redlightASl/OurEDA-B2S/Doc/动力舱控制板接插件v2.jpg

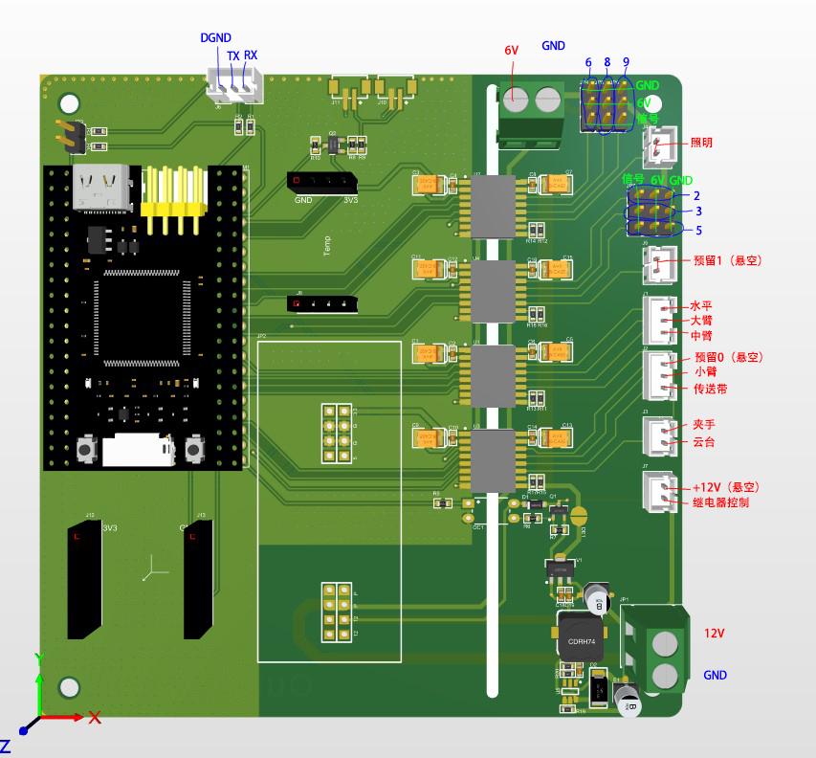
Doc/动力舱控制板接插件v2.jpg
