redlightASl/OurEDA-B2S/Doc/GW1NSR架构图.jpg

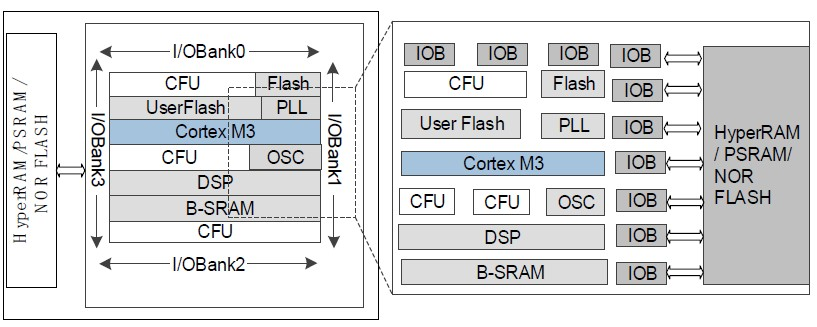
Doc/GW1NSR架构图.jpg
