redlightASl/OurEDA-B2S/README.md

# OurEDA-B2S

一个水下机器人（ROV/AUV）的下位仓控制系统，由[OurEDA-B1S](https://github.com/zyn810039594/OurEDA-B1S)更新得来

请使用Arduino、CubeMX、CubeIDE访问相关代码，使用AD打开硬件原理图和PCB Layout设计

系统架构图如`Doc/OurEDA-B2S`所示

## 子模块Submodule

该项目衍生出的仓库包括

[小体积水深解算板](https://github.com/redlightASl/ROV_SensorBoard)

[AD常用封装库整理](https://github.com/redlightASl/Lib-ADP)
