redlightASl/OurEDA-B2S/Software/WaterDepth/README.md

# 水深传感器解算板

**测试中发现I2C传输出现问题**

暂未修复

考虑到后续需要添加其他I2C设备，故制作基于GD32/STM32的新款水深解算板

## 已废弃
