redlightASl/OurEDA-B2S/Hardware/Board/CtrlCarbinBoard/CtrlCarbinBoard.PcbDoc.htm

Reporting Options

# File in Previous Format

Date | : | 2022/4/24
Time | : | 15:39:36
Filename | : | F:\Git_repository\OurEDA\OurEDA-B2S\Hardware\Board\CtrlCarbinBoard\CtrlCarbinBoard.PcbDoc

Version | Warning

This file was generated by an earlier version of the software
