redlightASl/OurEDA-B2S/Hardware/Board/WaterDepthAnalysisBoard/WaterDepth.PcbDoc.htm

Reporting Options

# File in Previous Format

Date | : | 2022/3/30
Time | : | 19:57:03
Filename | : | F:\Git_repository\OurEDA\OurEDA-B2S\Hardware\Board\WaterDepthAnalysisBoard\WaterDepth.PcbDoc

Version | Warning

This file was generated by an earlier version of the software
