redlightASl/OurEDA-B2S/DataFormat/README.md

# 自定义协议帧

使用串口实现协议传输

下传指令格式：CtrlFormat.xlsx

上传指令格式：DataFormat.xlsx

### ROV-Debugger格式

`05DC:05DC:05DC:05DC:05DC:05DC:05DC:05DC:05DC:05DC:05DC:05DC:05DC`
