redlightASl/OurEDA-B2S/OpenWrt/README.md

# 控制仓的OpenWrt移植

控制仓中使用一个OpenWrt设备作为网络主控

配合stm32h750读取传感器数据和进行辅助计算

（如果后续有可能的话会使用Zynq将所有设备取代）

## 初步设计

使用**MT7688A**模块替代原来的MT7921模块，新模块特性如下

* 降级为百兆交换机/路由器
* 更高的CPU频率
* 支持WIFI
* 更好的openwrt官方支持（新版本，支持大多数需要的软件包）
* 更小的体积占用

测试中出现以下bug：

* ~~硬件复位卡死~~
* ~~软件复位reboot卡死~~
* **不提供固件、uboot，如果损坏只能维修或重新购买设备**
* usb引出存在问题（可能由于杜邦线问题导致USB连接失灵时不灵）
* 多摄像头传输时帧数明显低于7621（影响较小）
