redlightASl/OurEDA-B2S/Hardware/Board/README.md

# 硬件设计

CtrlCarbinBoard 控制仓PCB

PowCarbinBoard 电源仓PCB

WaterDepthAnalysisBoard 水深解算板PCB
