redlightASl/OurEDA-B2S/Hardware/Board/WaterDepthAnalysisBoard/README.md

# 水深传感器解算板

使用stm8重写深度解算板的程序，并采用邮票孔封装（因为没钱拼板，实际使用2.54排针，直接切割焊盘分成两块板）制作成电路模块
