redlightASl/OurEDA-B2S/Doc/M3硬核架构图.jpg

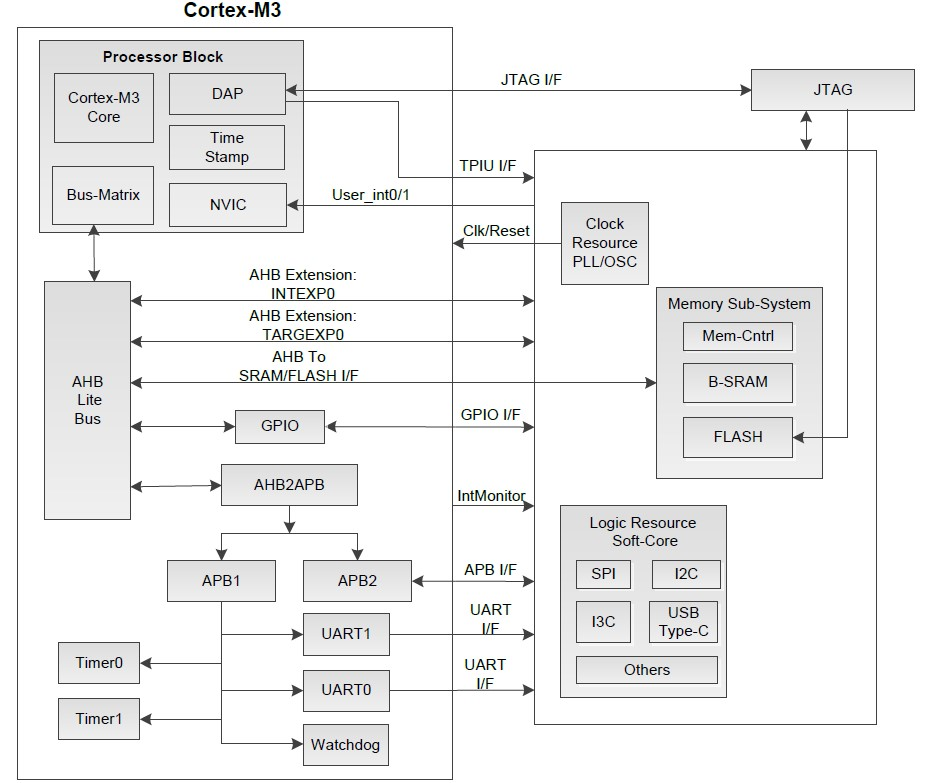
Doc/M3硬核架构图.jpg
