redlightASl/OurEDA-B2S/Hardware/Board/WaterDepthAnalysisBoard/Project Outputs for WaterDepth/WaterDepth.xls

Comment | Description | Designator | Footprint | LibRef | Quantity
104 | 无极性贴片电容 | C1, C2, C3, C4, C5, C6, C7, C8, C9, C10 | C 0603_L | C | 10
HDR-1X4 | 4P接插件 | JP1, JP2 | MX 1.25-LS-4P | Header 4 | 2
Header 8X2 | 8*2P接插件 | JP3 | HDR2.54-LI-2x8P | Header 8X2 | 1
红色 | 贴片LED | LED1, LED2, LED3, LED4 | LED 0603W | LED-SMD | 4
NPN | NPN三极管 | Q1, Q2 | SOT-23 | NPN | 2
33K | 贴片电阻 | R1, R5 | R 0603_L | R | 2
3.3K | 贴片电阻 | R2, R3, R4, R6, R7, R8 | R 0603_L | R | 6
4.7K | 贴片电阻 | R9, R10, R11, R12 | R 0603_L | R | 4
TEST | 测试点 | TP1, TP2, TP3, TP4, TP5, TP6, TP7, TP8 | TEST 1 | TEST | 8
STM8L101F3P6 | MCU | U1, U2 | TSSOP-20 | STM8L101F3P6 | 2
AMS1117-3V3 | 三端稳压芯片 | V1, V2 | SOT89_N | AMS1117 | 2
