redlightASl/OurEDA-B2S/(list of files, cad)

Other CAD files:
Software/WaterDepth/stm8_uart.stp
Software/WaterDepth/stm8_uart_Programmer/stm8_uart_STVP.stp
