redlightASl/OurEDA-B2S/Hardware/Board/PowCarbinBoard/PowCarbinBoard.pdf

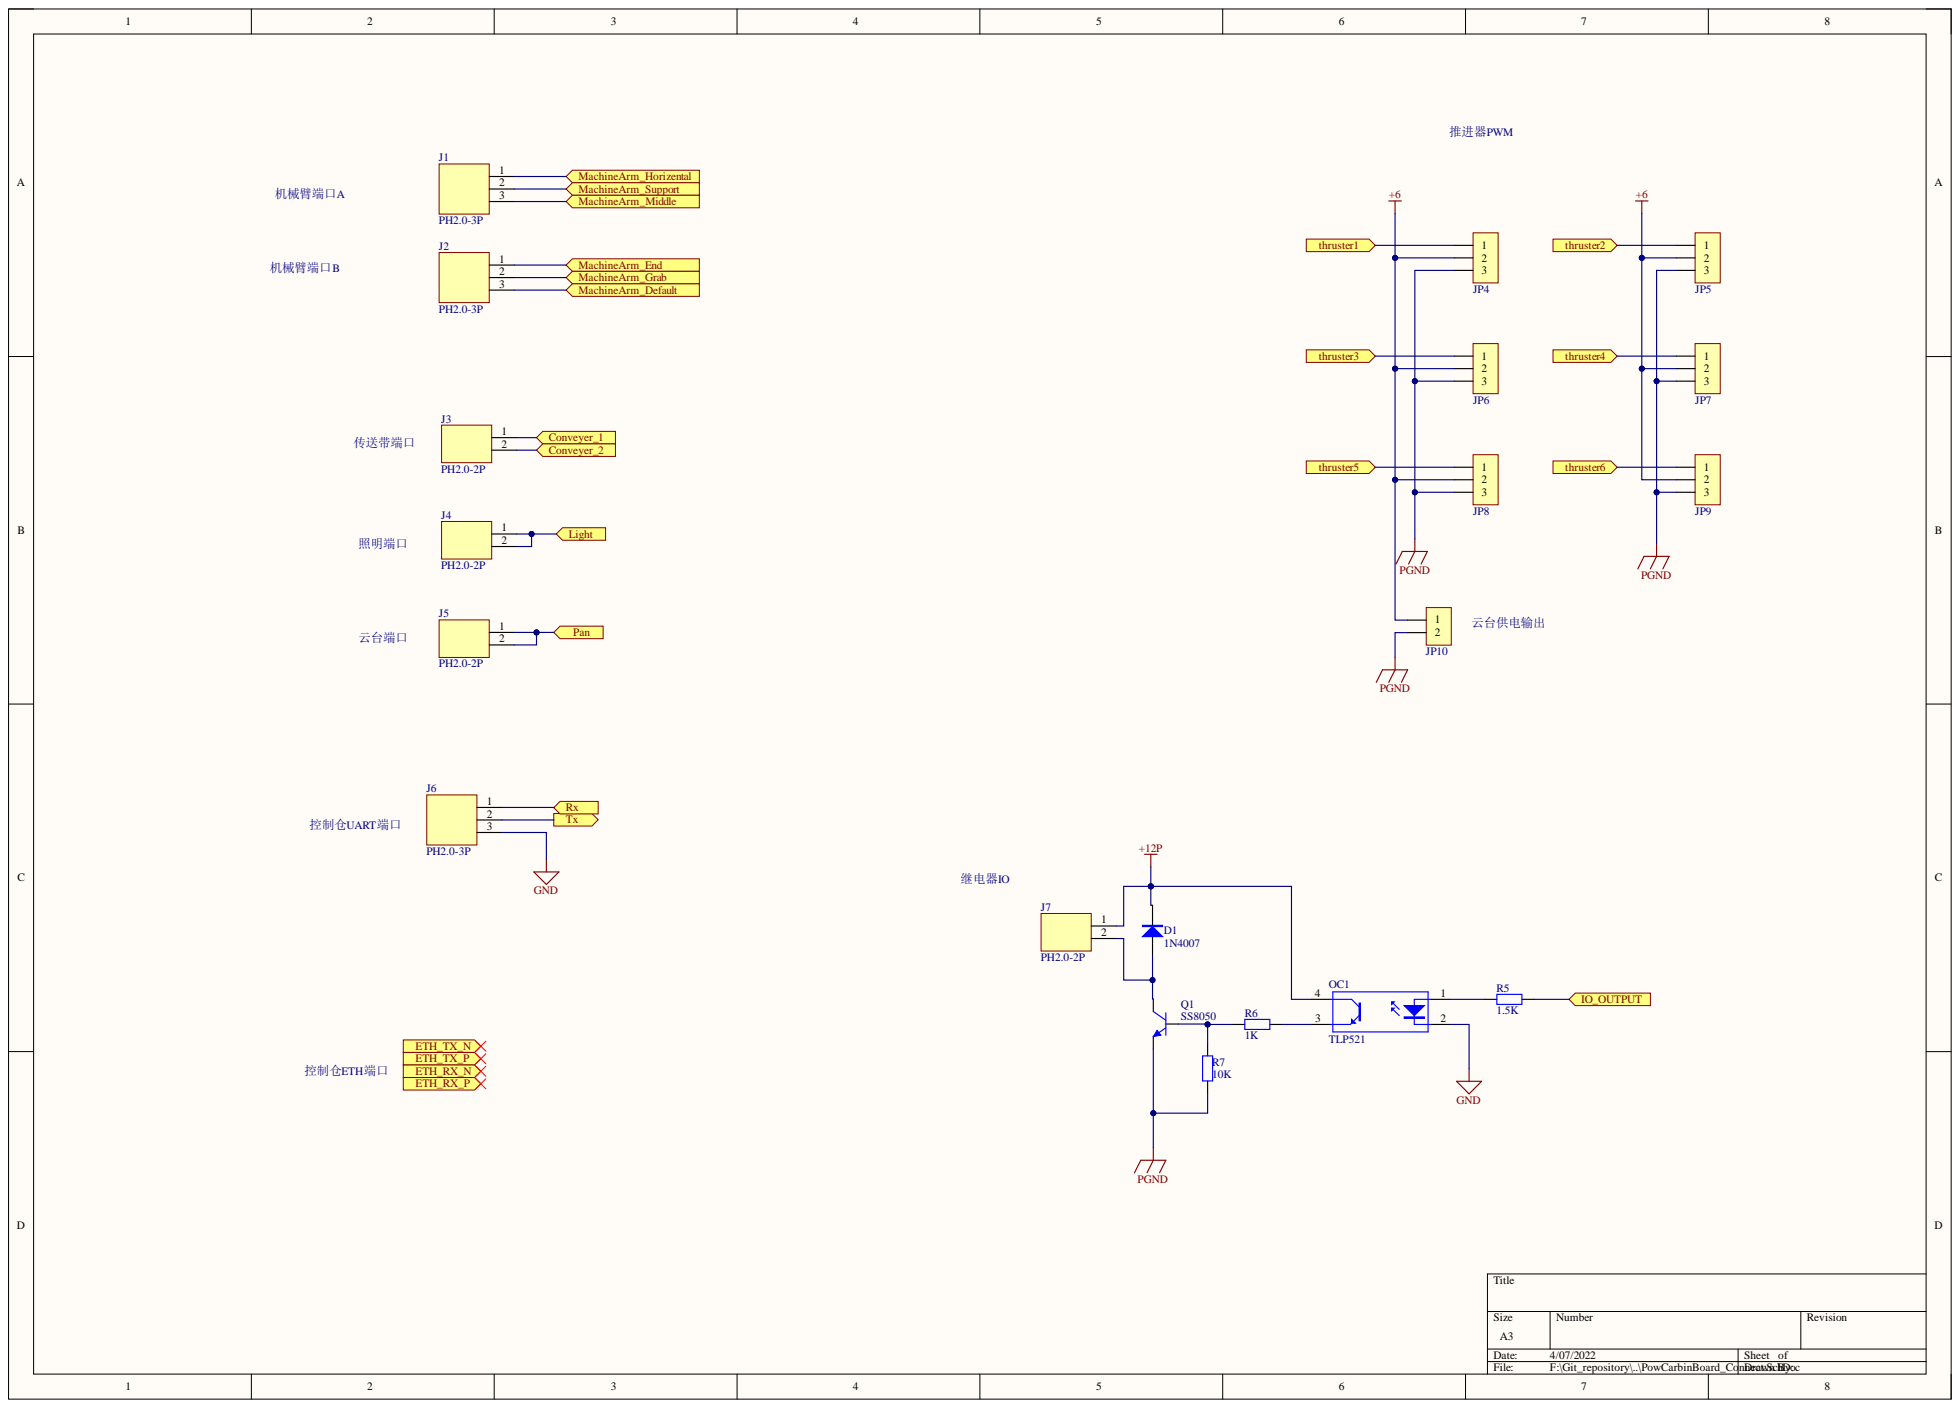
[picture p4: page 1]

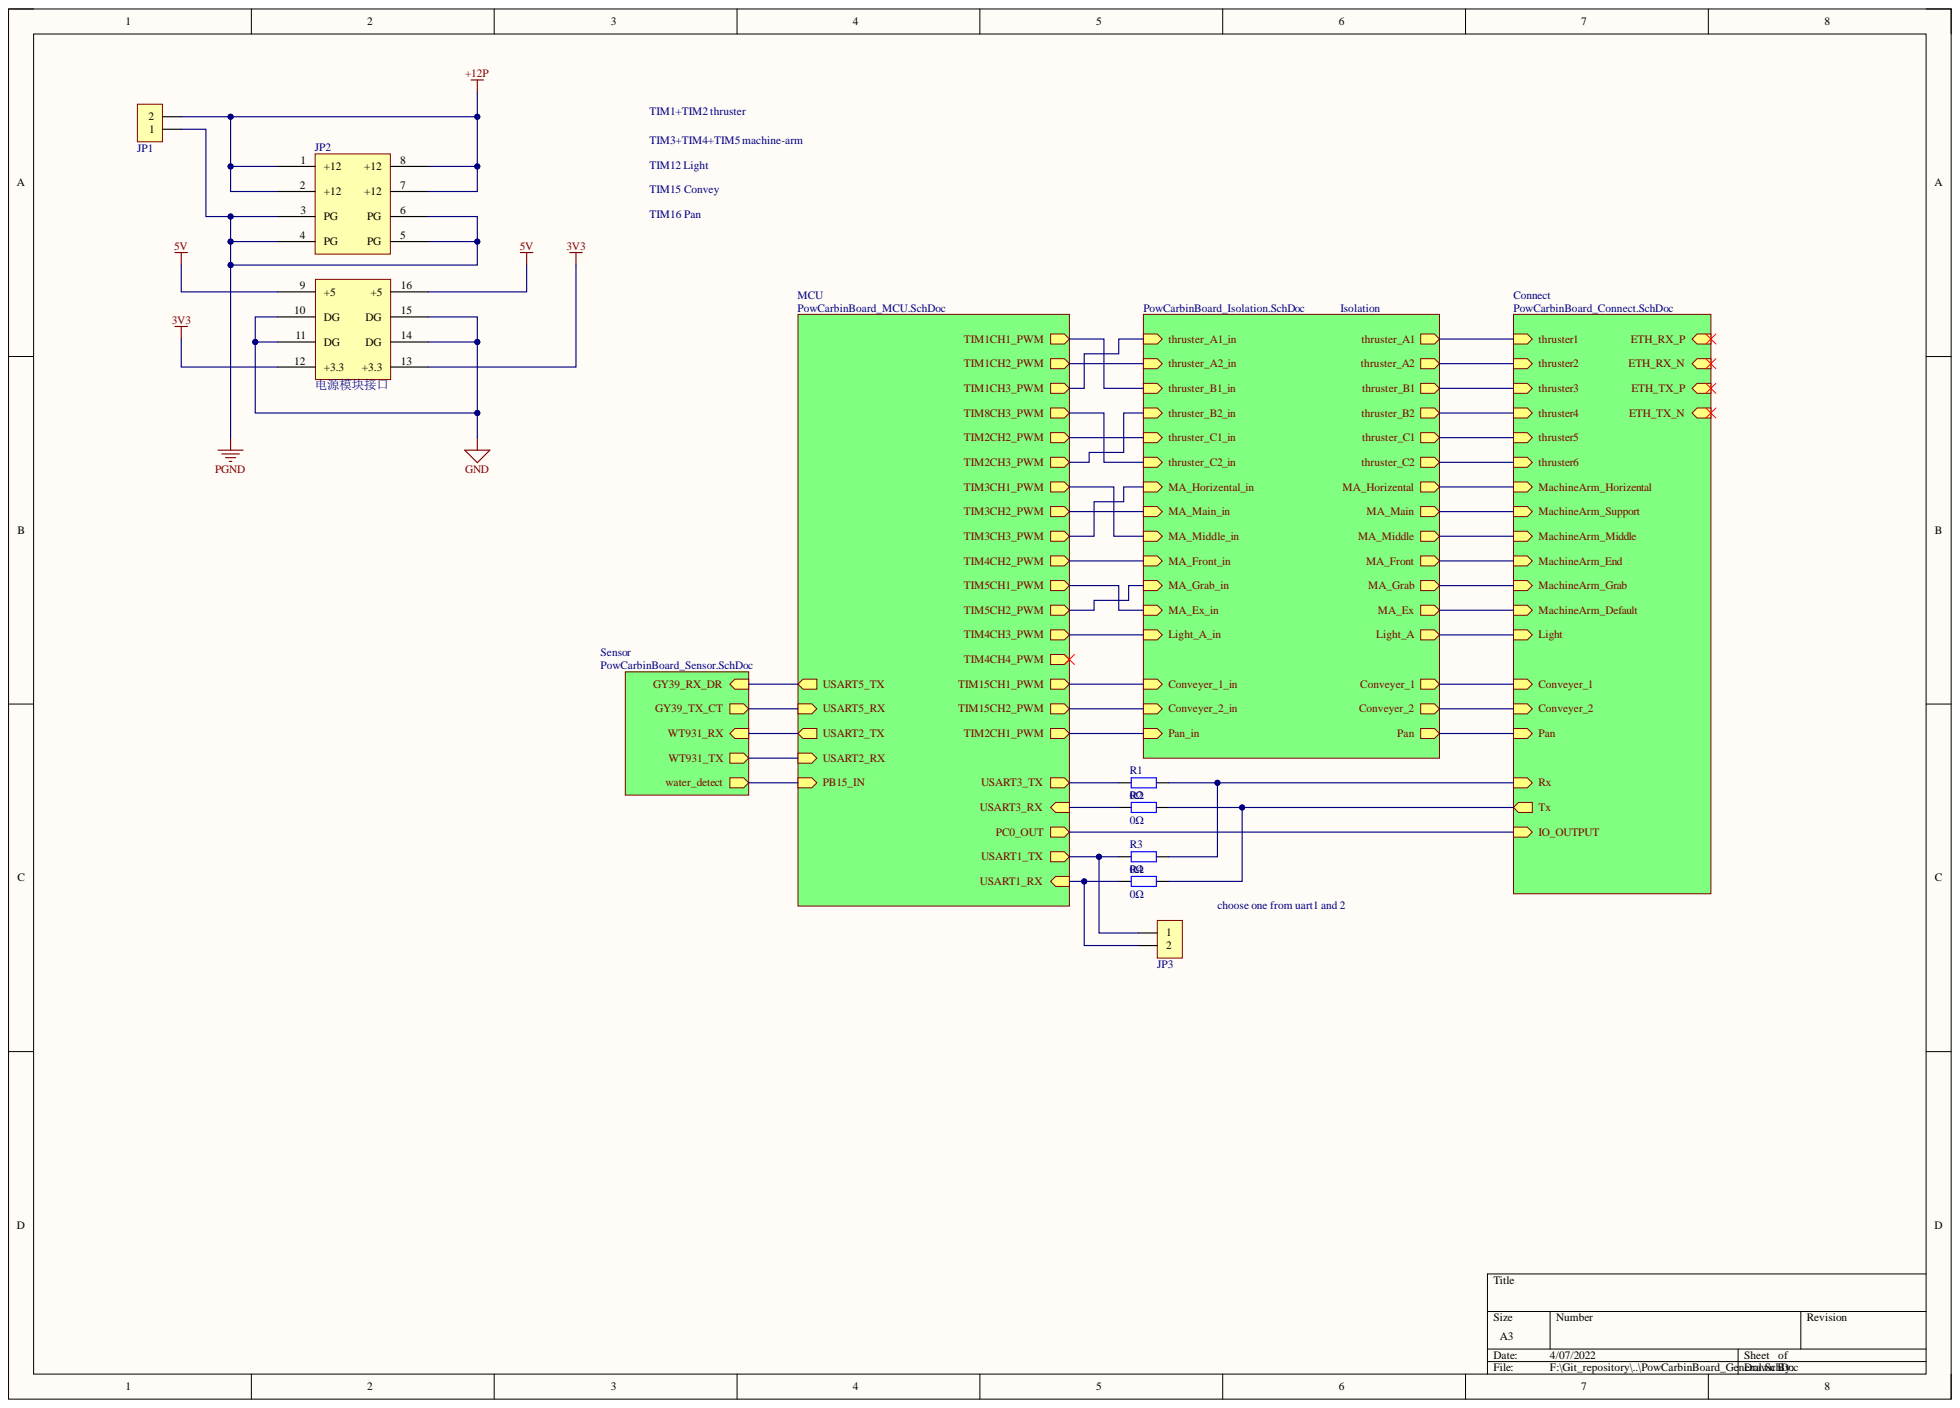
[picture p5: page 2]

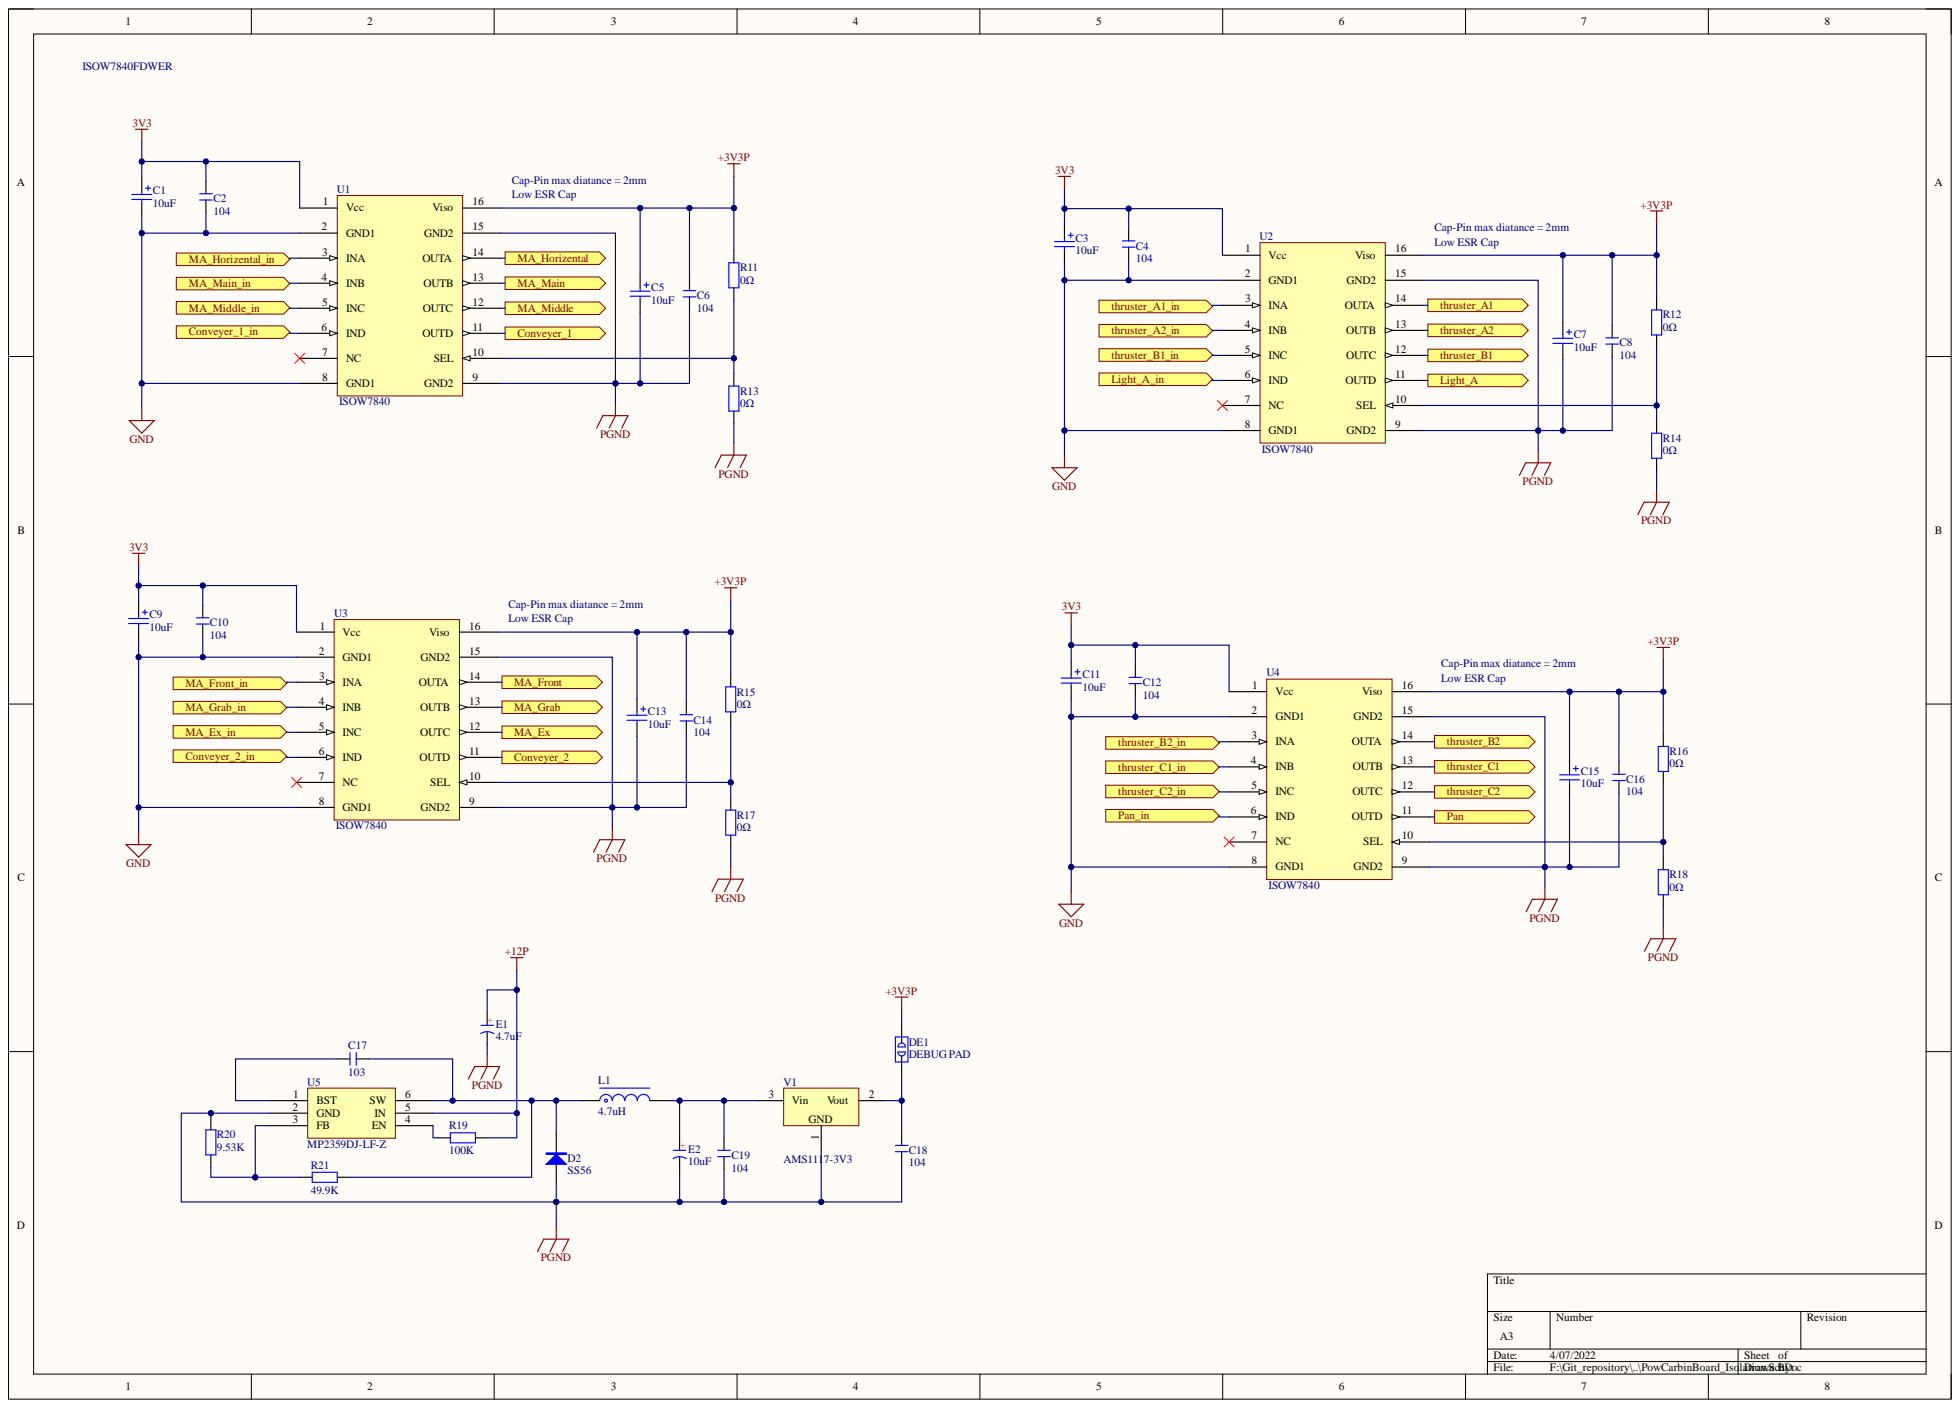
[picture p6: page 3]

Cap-Pin max diatance = 2mm
Low ESR Cap

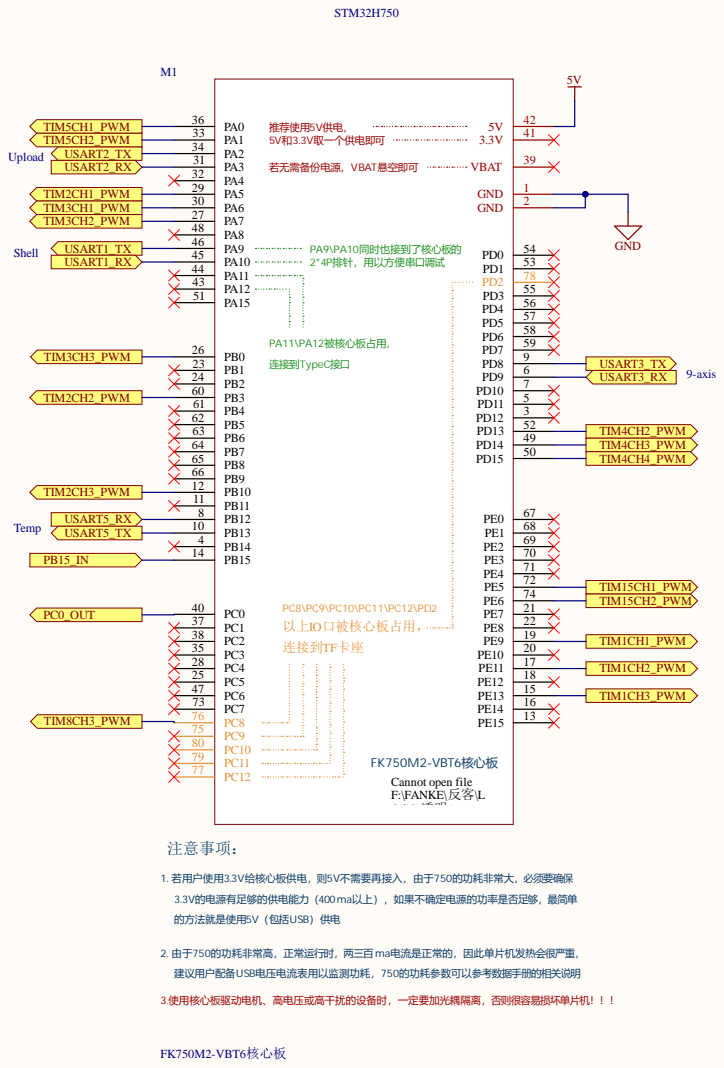
[picture p7: page 4]

3.使用核心板驱动电机、高电压或高干扰的设备时，一定要加光耦隔离，否则很容易损坏单片机！！！

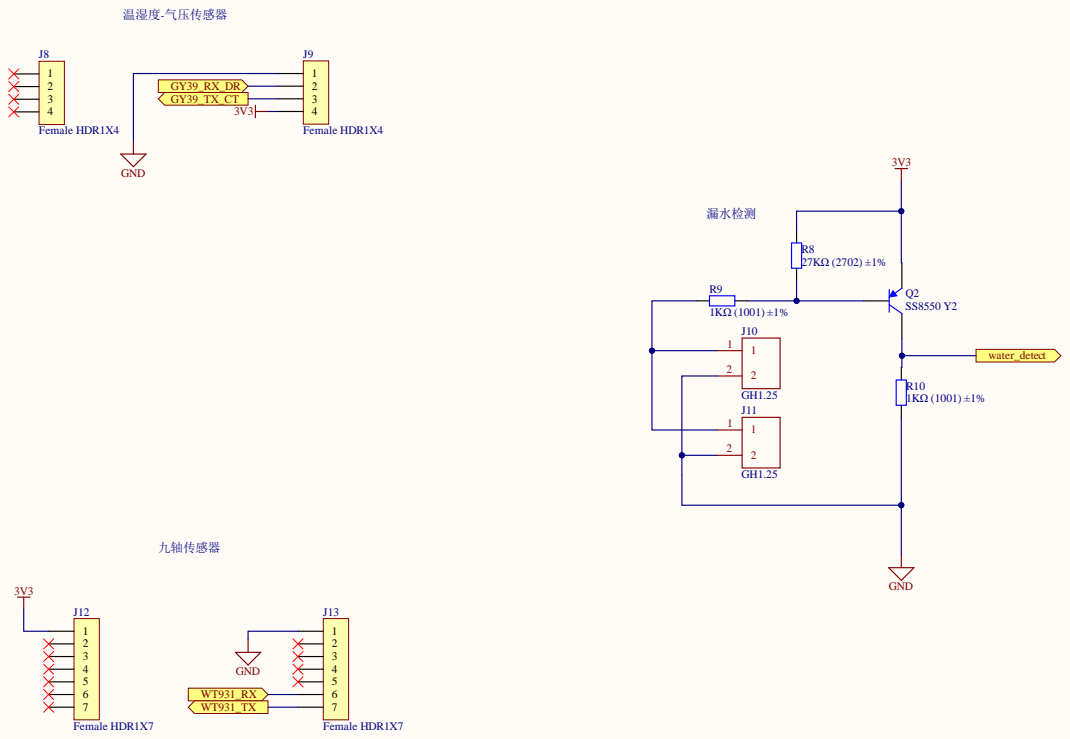
[picture p8: page 5]

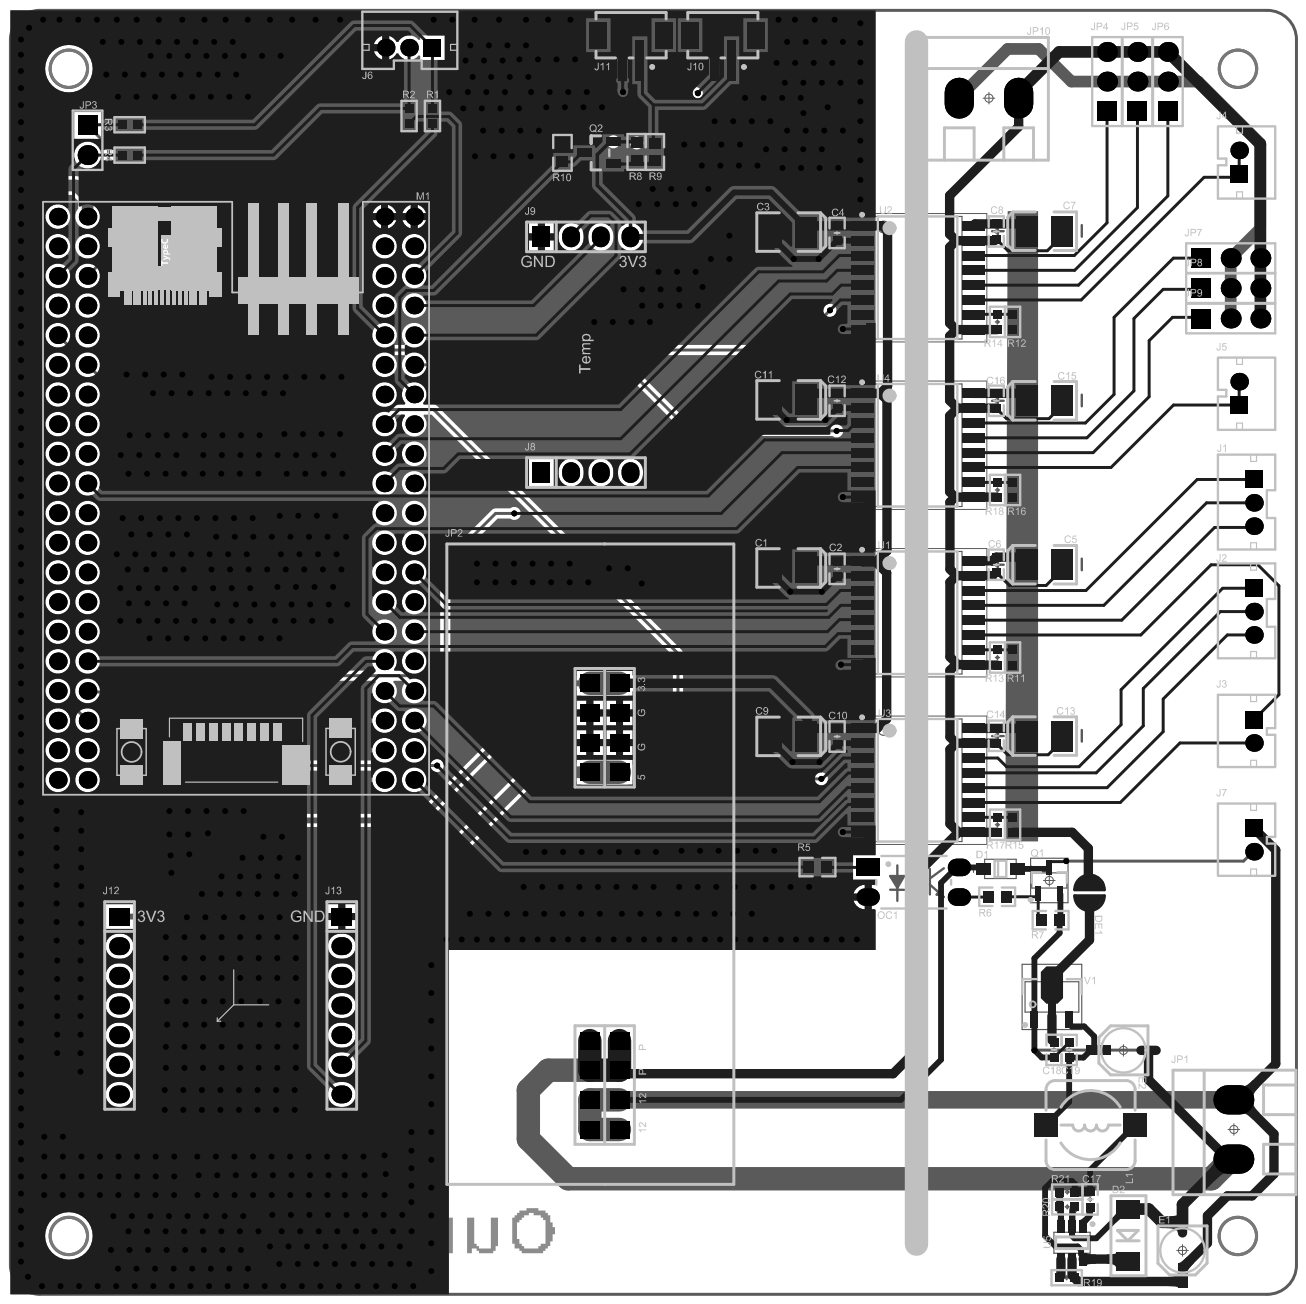
[picture p9: page 6]
