redlightASl/OurEDA-B2S/Hardware/Board/WaterDepthAnalysisBoard/WaterDepth.pdf

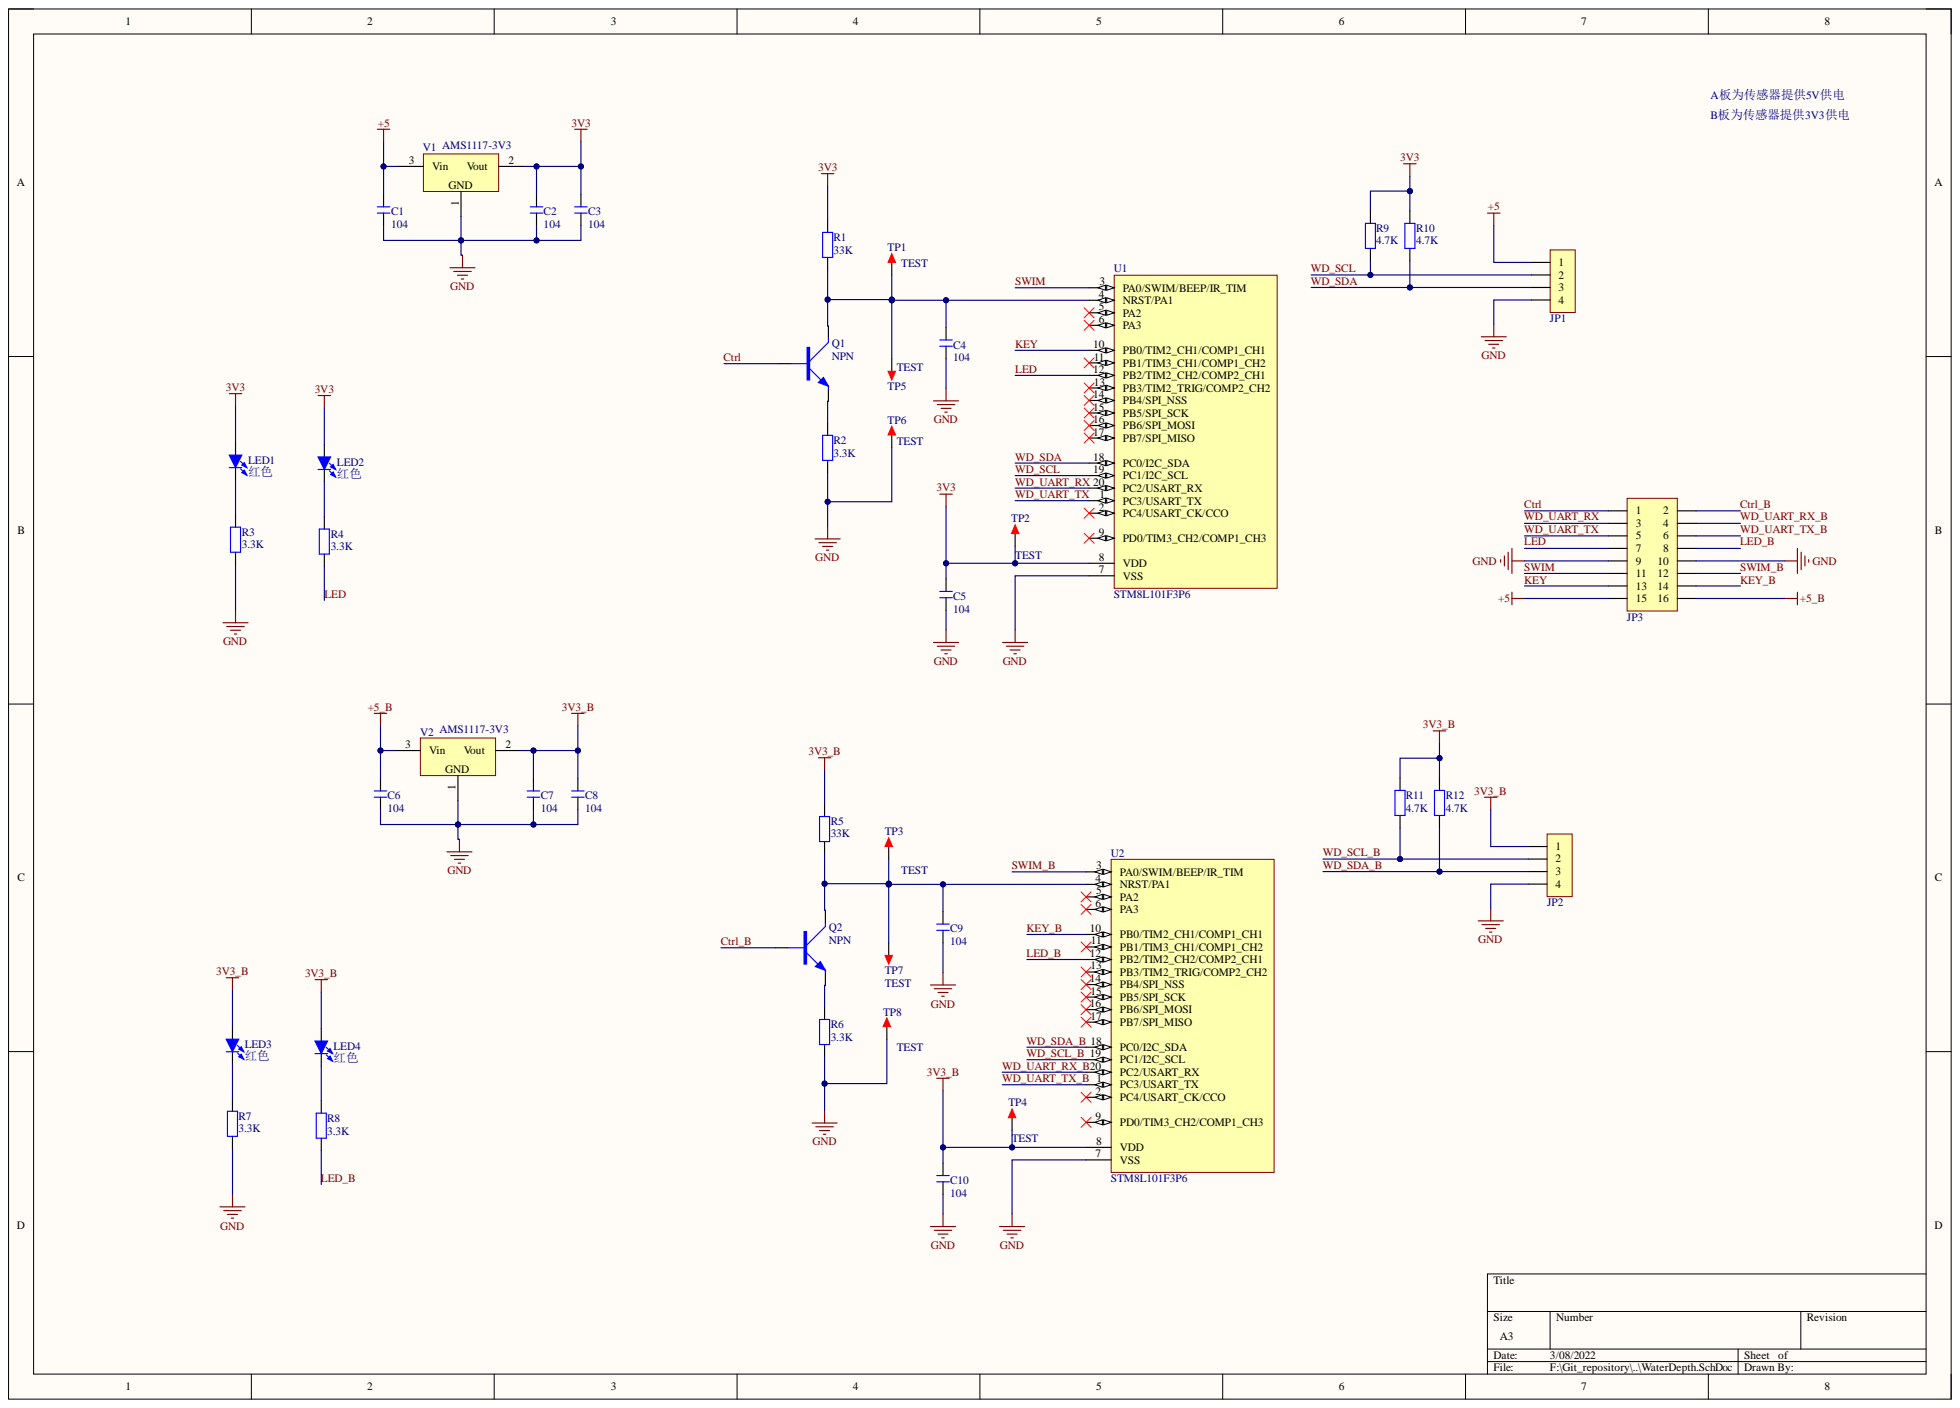
[picture p10: page 1]

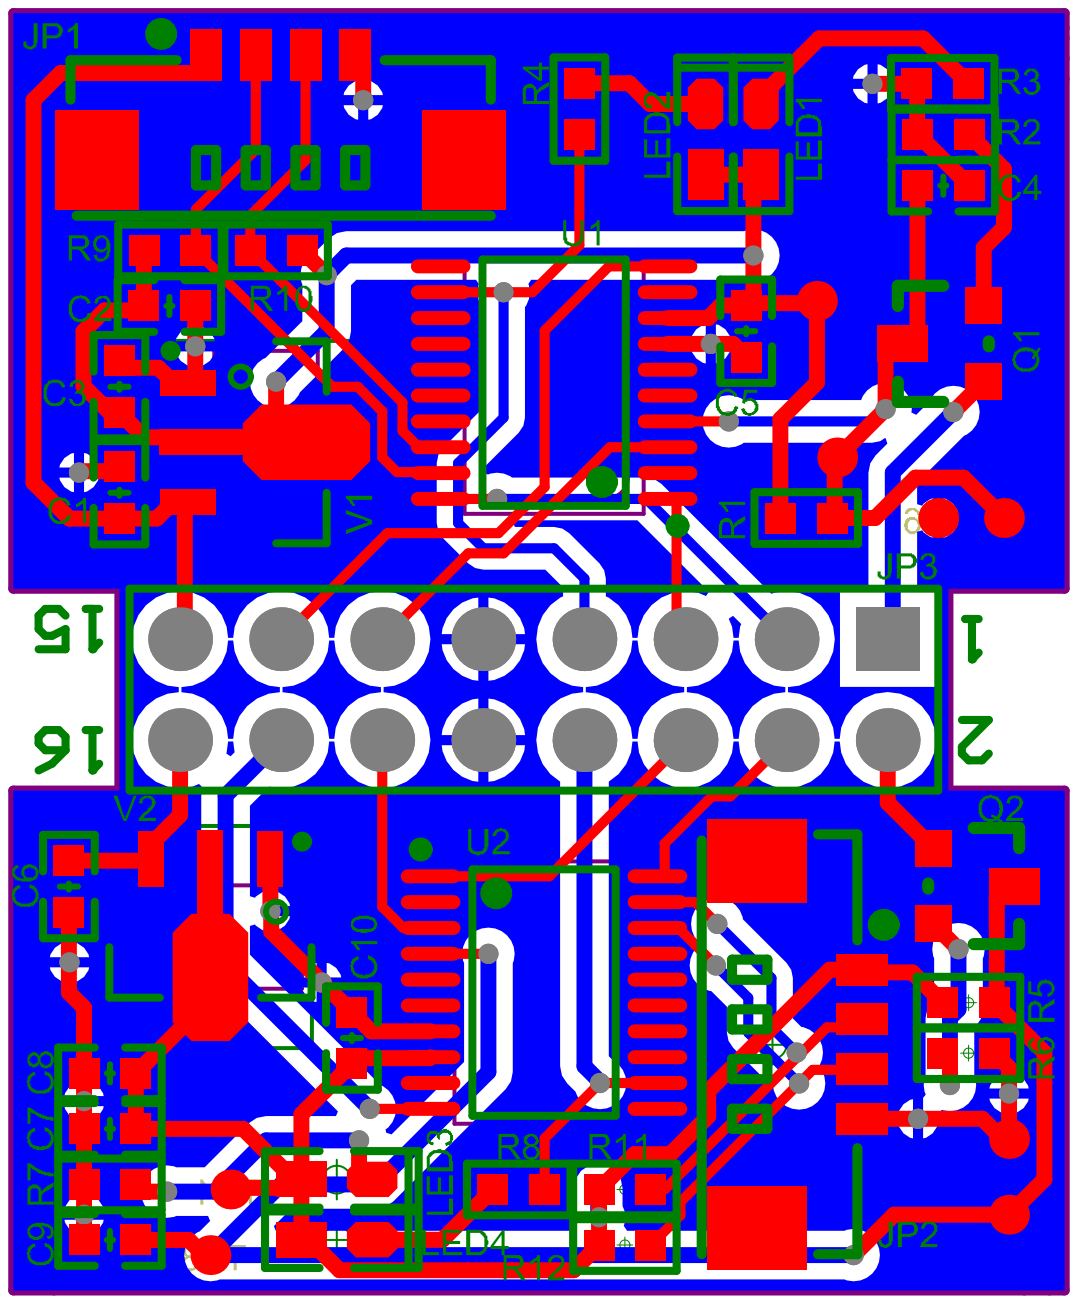
[picture p11: page 2]
