redlightASl/OurEDA-B2S/Hardware/Board/WaterDepthAnalysisBoard/Project Outputs for WaterDepth/WaterDepth.pdf

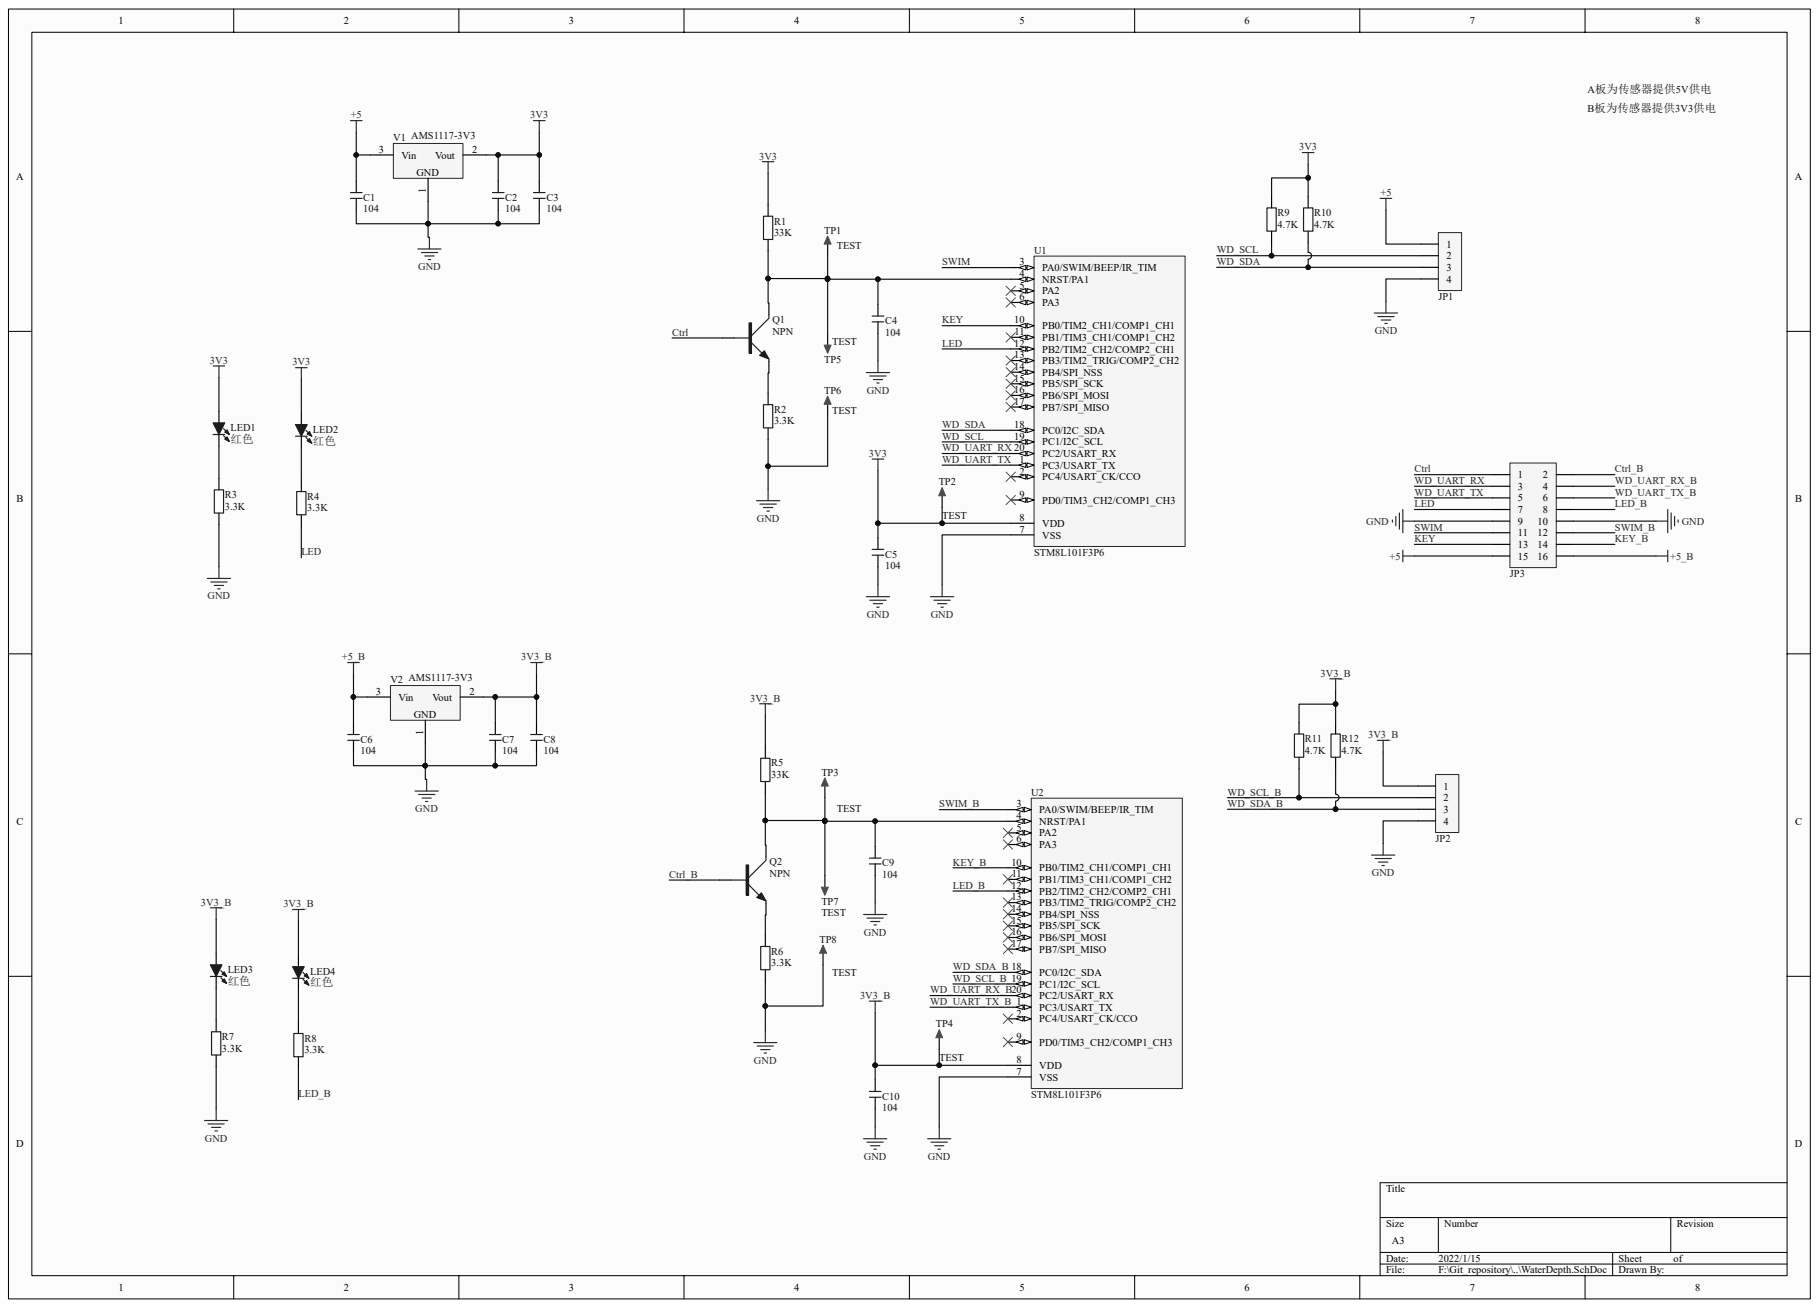
[picture p12: page 1]

Size A3 | Number | Revision

Date: 2022/1/15 | Sheet of
File: F:\Git_repository\..\WaterDepth.SchDoc | Drawn By:
