redlightASl/OurEDA-B2S/Doc/OurEDA-B2S.pdf

# OurEDA-B2S

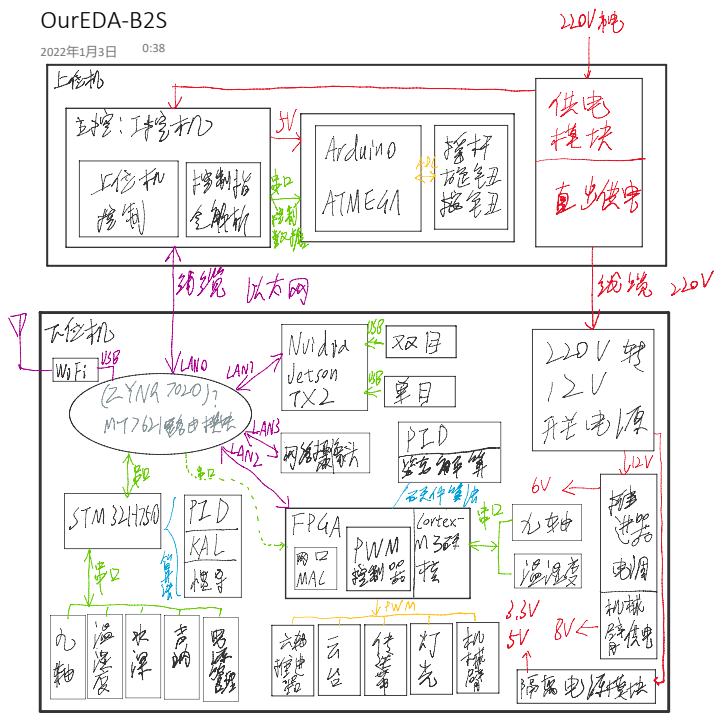
[picture p13: page 1]
