redlightASl/OurEDA-B2S/(list of files, drawings)

Other design files:
Hardware/Board/CtrlCarbinBoard/CtrlCarbinBoard.PcbDoc
Hardware/Board/CtrlCarbinBoard/CtrlCarbinBoard.PrjPCB
Hardware/Board/CtrlCarbinBoard/CtrlCarbinBoard_Common.SchDoc
Hardware/Board/CtrlCarbinBoard/CtrlCarbinBoard_MCU.SchDoc
Hardware/Board/CtrlCarbinBoard/CtrlCarbinBoard_NetConnection.SchDoc
Hardware/Board/CtrlCarbinBoard/CtrlCarbinBoard_Processor.SchDoc
Hardware/Board/PowCarbinBoard/PowCarbinBoard.PrjPCB
Hardware/Board/PowCarbinBoard/PowCarbinBoard_Connect.SchDoc
Hardware/Board/PowCarbinBoard/PowCarbinBoard_General.SchDoc
Hardware/Board/PowCarbinBoard/PowCarbinBoard_Isolation.SchDoc
Hardware/Board/PowCarbinBoard/PowCarbinBoard_MCU.SchDoc
Hardware/Board/PowCarbinBoard/PowCarbinBoard_Sensor.SchDoc
Hardware/Board/PowCarbinBoard_FPGA/PowCarbinBoard_Connect.SchDoc
Hardware/Board/PowCarbinBoard_FPGA/PowCarbinBoard_FPGA.SchDoc
Hardware/Board/PowCarbinBoard_FPGA/PowCarbinBoard_General.SchDoc
Hardware/Board/PowCarbinBoard_FPGA/PowCarbinBoard_Isolation.SchDoc
Hardware/Board/PowCarbinBoard_FPGA/PowCarbinBoard_Sensor.SchDoc
Hardware/Board/WaterDepthAnalysisBoard/WaterDepth.PcbDoc
Hardware/Board/WaterDepthAnalysisBoard/WaterDepth.PrjPCB
Hardware/Board/WaterDepthAnalysisBoard/WaterDepth.SchDoc
Hardware/Board/WaterDepthAnalysisBoardv2/WaterDepthAnalysisBoardv2.PrjPcb
Hardware/Board/WaterDepthAnalysisBoardv2/WaterDepthAnalysisBoardv2.SchDoc
