redlightASl/OurEDA-B2S/Software/OurEDA-B2S_PowH7/OurEDA-B2S_PowH7.ioc

Mcu.UserName=STM32H750VBTx
PA0.Signal=S_TIM5_CH1
PA1.Signal=S_TIM5_CH2
PA10.Signal=USART1_RX
PA2.Signal=USART2_TX
PA3.Signal=USART2_RX
PA5.Signal=S_TIM2_CH1_ETR
PA6.Signal=S_TIM3_CH1
PA7.Signal=S_TIM3_CH2
PA9.Signal=USART1_TX
PB0.Signal=S_TIM3_CH3
PB10.Signal=S_TIM2_CH3
PB12.Signal=UART5_RX
PB13.Signal=UART5_TX
PB14.Signal=S_TIM12_CH1
PB15.GPIO_Label=WaterDet
PB15.Signal=GPIO_Input
PC0.GPIO_Label=Relay
PC0.Signal=GPIO_Output
PC13.GPIO_Label=LED
PC13.Signal=GPIO_Output
PC8.Signal=S_TIM8_CH3
PD13.Signal=S_TIM4_CH2
PD14.Signal=S_TIM4_CH3
PD15.Signal=S_TIM4_CH4
PD8.Signal=USART3_TX
PD9.Signal=USART3_RX
PE11.Signal=S_TIM1_CH2
PE13.Signal=S_TIM1_CH3
PE5.Signal=S_TIM15_CH1
PE6.Signal=S_TIM15_CH2
PE9.Signal=S_TIM1_CH1
