redlightASl/OurEDA-B2S/Software/OurEDA-B2S_CtrlH7/Core/Inc/main.h

#define LED_Pin GPIO_PIN_13
#define LED_GPIO_Port GPIOC
#define WATER_DET_Pin GPIO_PIN_6
#define WATER_DET_GPIO_Port GPIOE
