redlightASl/OurEDA-B2S/Software/WaterDepth/stm8l10x_it.c

/**
  ******************************************************************************
  * @file    stm8l10x_it.c
  * @author  MCD Application Team
  * @version V1.2.1
  * @date    30-September-2014
  * @brief   This file contains all the interrupt routines.
  ******************************************************************************
  * @attention
  *
  * <h2><center>&copy; COPYRIGHT 2014 STMicroelectronics</center></h2>
  *
  * Licensed under MCD-ST Liberty SW License Agreement V2, (the "License");
  * You may not use this file except in compliance with the License.
  * You may obtain a copy of the License at:
  *
  *        http://www.st.com/software_license_agreement_liberty_v2
  *
  * Unless required by applicable law or agreed to in writing, software 
  * distributed under the License is distributed on an "AS IS" BASIS, 
  * WITHOUT WARRANTIES OR CONDITIONS OF ANY KIND, either express or implied.
  * See the License for the specific language governing permissions and
  * limitations under the License.
  *
  ******************************************************************************
  */

/* Includes ------------------------------------------------------------------*/
#include "stm8l10x_it.h"
#include "main.h"

/* Private typedef -----------------------------------------------------------*/
/* Private define ------------------------------------------------------------*/
/* Private macro -------------------------------------------------------------*/

/* Private variables ---------------------------------------------------------*/

/* Private function prototypes -----------------------------------------------*/
/* Private functions ---------------------------------------------------------*/


/* Public functions ----------------------------------------------------------*/

/**
  * @brief Dummy interrupt routine
  * @param  None
  * @retval None
  */
#ifdef _COSMIC_
INTERRUPT_HANDLER(NonHandledInterrupt,0)
{
    /* In order to detect unexpected events during development,
       it is recommended to set a breakpoint on the following instruction.
    */
}
#endif

/**
  * @brief TRAP interrupt routine
  * @param  None
  * @retval None
  */
INTERRUPT_HANDLER_TRAP(TRAP_IRQHandler)
{
    /* In order to detect unexpected events during development,
       it is recommended to set a breakpoint on the following instruction.
    */
}

/**
  * @brief FLASH Interrupt routine.
  * @param  None
  * @retval None
  */
INTERRUPT_HANDLER(FLASH_IRQHandler,1)
{
    /* In order to detect unexpected events during development,
       it is recommended to set a breakpoint on the following instruction.
    */
}

/**
  * @brief Auto Wake Up Interrupt routine.
  * @param  None
  * @retval None
  */
INTERRUPT_HANDLER(AWU_IRQHandler,4)
{
    /* In order to detect unexpected events during development,
       it is recommended to set a breakpoint on the following instruction.
    */
}

/**
  * @brief External IT PORTB Interrupt routine.
  * @param  None
  * @retval None
  */
INTERRUPT_HANDLER(EXTIB_IRQHandler, 6)
{
    /* In order to detect unexpected events during development,
       it is recommended to set a breakpoint on the following instruction.
    */
}

/**
  * @brief External IT PORTD Interrupt routine.
  * @param  None
  * @retval None
  */
INTERRUPT_HANDLER(EXTID_IRQHandler, 7)
{
    /* In order to detect unexpected events during development,
       it is recommended to set a breakpoint on the following instruction.
    */
}

/**
  * @brief External IT PIN0 Interrupt routine.
  * @param  None
  * @retval None
  */
INTERRUPT_HANDLER(EXTI0_IRQHandler, 8)
{
    /* In order to detect unexpected events during development,
       it is recommended to set a breakpoint on the following instruction.
    */
}

/**
  * @brief External IT PIN1 Interrupt routine.
  * @param  None
  * @retval None
  */
INTERRUPT_HANDLER(EXTI1_IRQHandler, 9)
{
    /* In order to detect unexpected events during development,
       it is recommended to set a breakpoint on the following instruction.
    */
}

/**
  * @brief External IT PIN2 Interrupt routine.
  * @param  None
  * @retval None
  */
INTERRUPT_HANDLER(EXTI2_IRQHandler, 10)
{
    /* In order to detect unexpected events during development,
       it is recommended to set a breakpoint on the following instruction.
    */
}

/**
  * @brief External IT PIN3 Interrupt routine.
  * @param  None
  * @retval None
  */
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
  * @retval None
  */
INTERRUPT_HANDLER(I2C_IRQHandler, 29)
{
    /* In order to detect unexpected events during development,
       it is recommended to set a breakpoint on the following instruction.
    */
}

/************************ (C) COPYRIGHT STMicroelectronics *****END OF FILE****/
