redlightASl/OurEDA-B2S/(commit log)

2022-01-15 Debug WDA
    [DownFormat.xlsx, UpFormat.xlsx, WaterDepth.PrjPCB, WaterDepth.SchDoc, WaterDepth.xls, stm8l10x.stp, stm8l10x_STVP.stp]
2022-01-30 Update DataFormats
    [CtrlFormat.xlsx, DataFormat.xlsx, DownFormat.xlsx, PowCarbinBoard.PrjPCB, PowCarbinBoard_FPGA.SchDoc, UpFormat.xlsx]
2022-02-12 Update MT7688
    [CtrlCarbinBoard_MCU.SchDoc, CtrlCarbinBoard_NetConnection.SchDoc, PowCarbinBoard_Connect.SchDoc, PowCarbinBoard_FPGA.SchDoc, PowCarbinBoard_Isolation.SchDoc, PowCarbinBoard_MCU.SchDoc, PowCarbinBoard_Power.SchDoc, PowCarbinBoard_Sensor.SchDoc]
2022-03-28 Update Hardware
    [CtrlCarbinBoard.PrjPCB, CtrlCarbinBoard_Common.SchDoc, CtrlCarbinBoard_MCU.SchDoc, CtrlCarbinBoard_NetConnection.SchDoc, CtrlCarbinBoard_Processor.SchDoc, PowCarbinBoard.PrjPCB, PowCarbinBoard_Connect.SchDoc, PowCarbinBoard_FPGA.SchDoc]
2022-10-15 Create PowH7
    [CtrlCarbinBoard.PrjPCB, CtrlCarbinBoard_Common.SchDoc, CtrlCarbinBoard_MCU.SchDoc, CtrlCarbinBoard_NetConnection.SchDoc, CtrlCarbinBoard_Processor.SchDoc, OurEDA-B2S_PowH7 Debug.cfg, PowCarbinBoard.PrjPCB, PowCarbinBoard_Connect.SchDoc]
2022-10-18 Finish Embedded Software v1.0
    [CtrlFormat.xlsx, DataFormat.xlsx]
2022-10-21 Debug: fix control problem, optimized data report timing
    [BasicCtrl.c, BasicCtrl.h, Sensor.c, Sensor.h, usart.c]
2022-10-21 Optimize UART delay and Catch Timing
