redlightASl/OurEDA-B2S/(notices)

Notices in the files:
Software/OurEDA-B2S_CtrlH7/Core/Src/usart.c:
Copyright (c) 2022 STMicroelectronics.
All rights reserved.
This software is licensed under terms that can be found in the LICENSE file
